TUO4742/SeedlingRobot/mechanical/四自由度/四自由度平行爪子.STEP

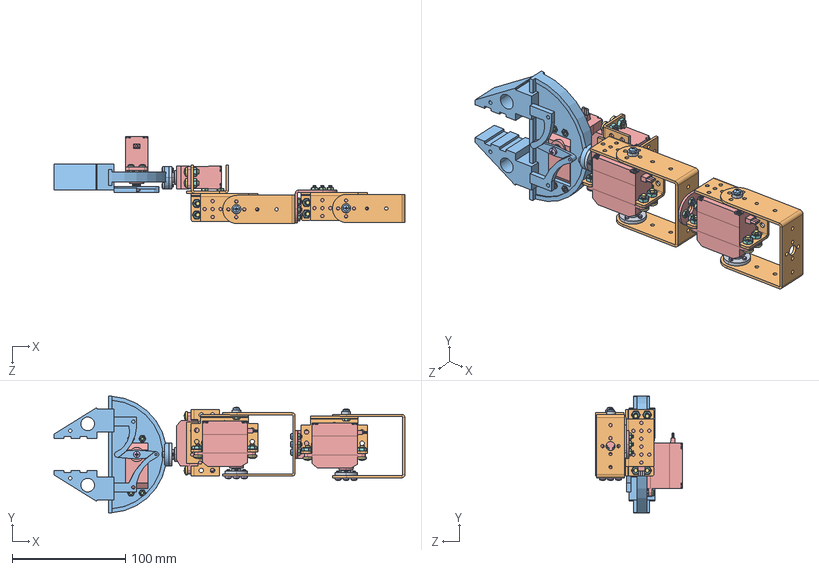
[picture p2: CAD file, 2026-10-20]
mechanical/四自由度/四自由度平行爪子.STEP
309.8 x 103.0 x 76.9 mm
ｱｭﾊｽﾖ盖ﾐ x 2
舵机支架 x 3
cross recessed pan head screws gb_GB_CROSS_SCREWS_TYPE1 M3X8-8 H type-S x 12
hex nuts, style 1-grades ab gb_GB_FASTENER_NUT_SNAB1 M3-S x 20
单轴舵机 x 4
cross recessed pan head screws gb_GB_CROSS_SCREWS_TYPE1 M3X6-6 H type-S x 14
cross recessed pan head screws gb_GB_CROSS_SCREWS_TYPE1 M4X10-10 H type-S x 12
hex nuts, style 1-grades ab gb_GB_FASTENER_NUT_SNAB1 M4-S x 12
金属主舵盘 x 3
酗U盓殤 x 2
す俴盓殤
cross recessed pan head screws gb_GB_CROSS_SCREWS_TYPE1 M3X10-10 H type-S x 4
L倰盓殤
