TUO4742/SeedlingRobot/mechanical/横梁/prt0004.stp

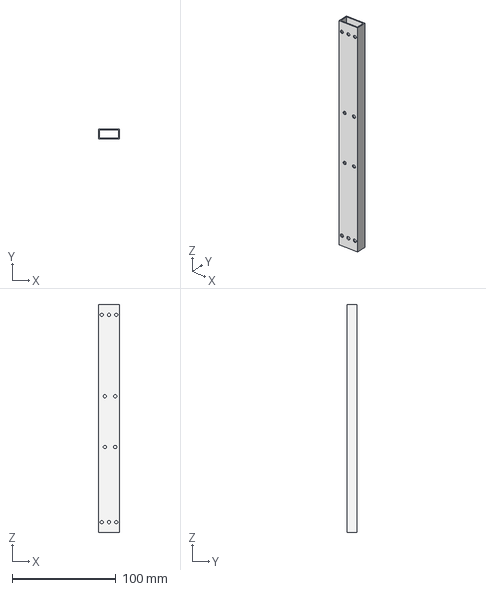
[picture p3: CAD file, 2026-10-20]
mechanical/横梁/prt0004.stp
20.0 x 10.0 x 220.0 mm
