TUO4742/SeedlingRobot/mechanical/完整小车.SLDASM

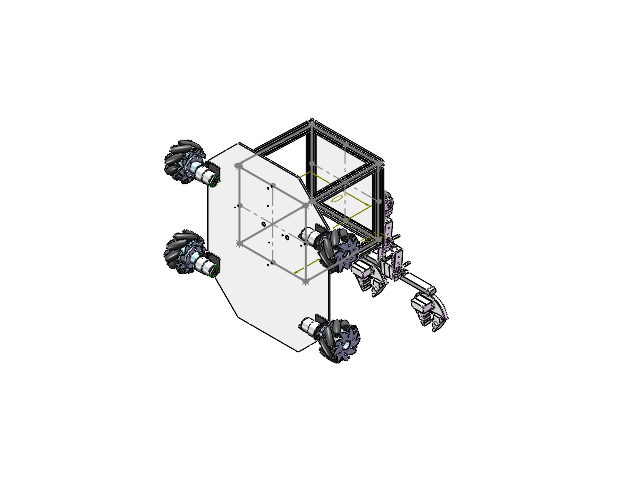
[picture p4: CAD file, 2026-10-20]
mechanical/完整小车.SLDASM
底盘
电机支架_MG513电机支架(37支架） x 4
直流电机_MG513P30（P20）-12V（霍尔） x 4
100mm麦轮_左 x 2
100mm麦轮_右 x 2
轴直径8mm_外径56.8mm_抱紧式联轴器_带法兰 x 4
铝型材支架
云台 x 2
零件18^小车底盘
u型支架 x 3
多功能支架 x 5
舵机 x 4
圆盘 x 2
90度支架
prt0004
夹爪 x 2
