TUO4742/SeedlingRobot/(list of files, cad)

Other CAD files:
mechanical/四自由度/四自由度平行爪子.DXF
mechanical/横梁/prt0004.STL
