TUO4742/SeedlingRobot/hardware/睿抗-摘苗机器人pcb/WLKJ2025011CAR-MOTOR-V1.2.kicad_pcb

## KiCad design hardware/睿抗-摘苗机器人pcb/WLKJ2025011CAR-MOTOR-V1.2.kicad_pcb (2026-10-20)

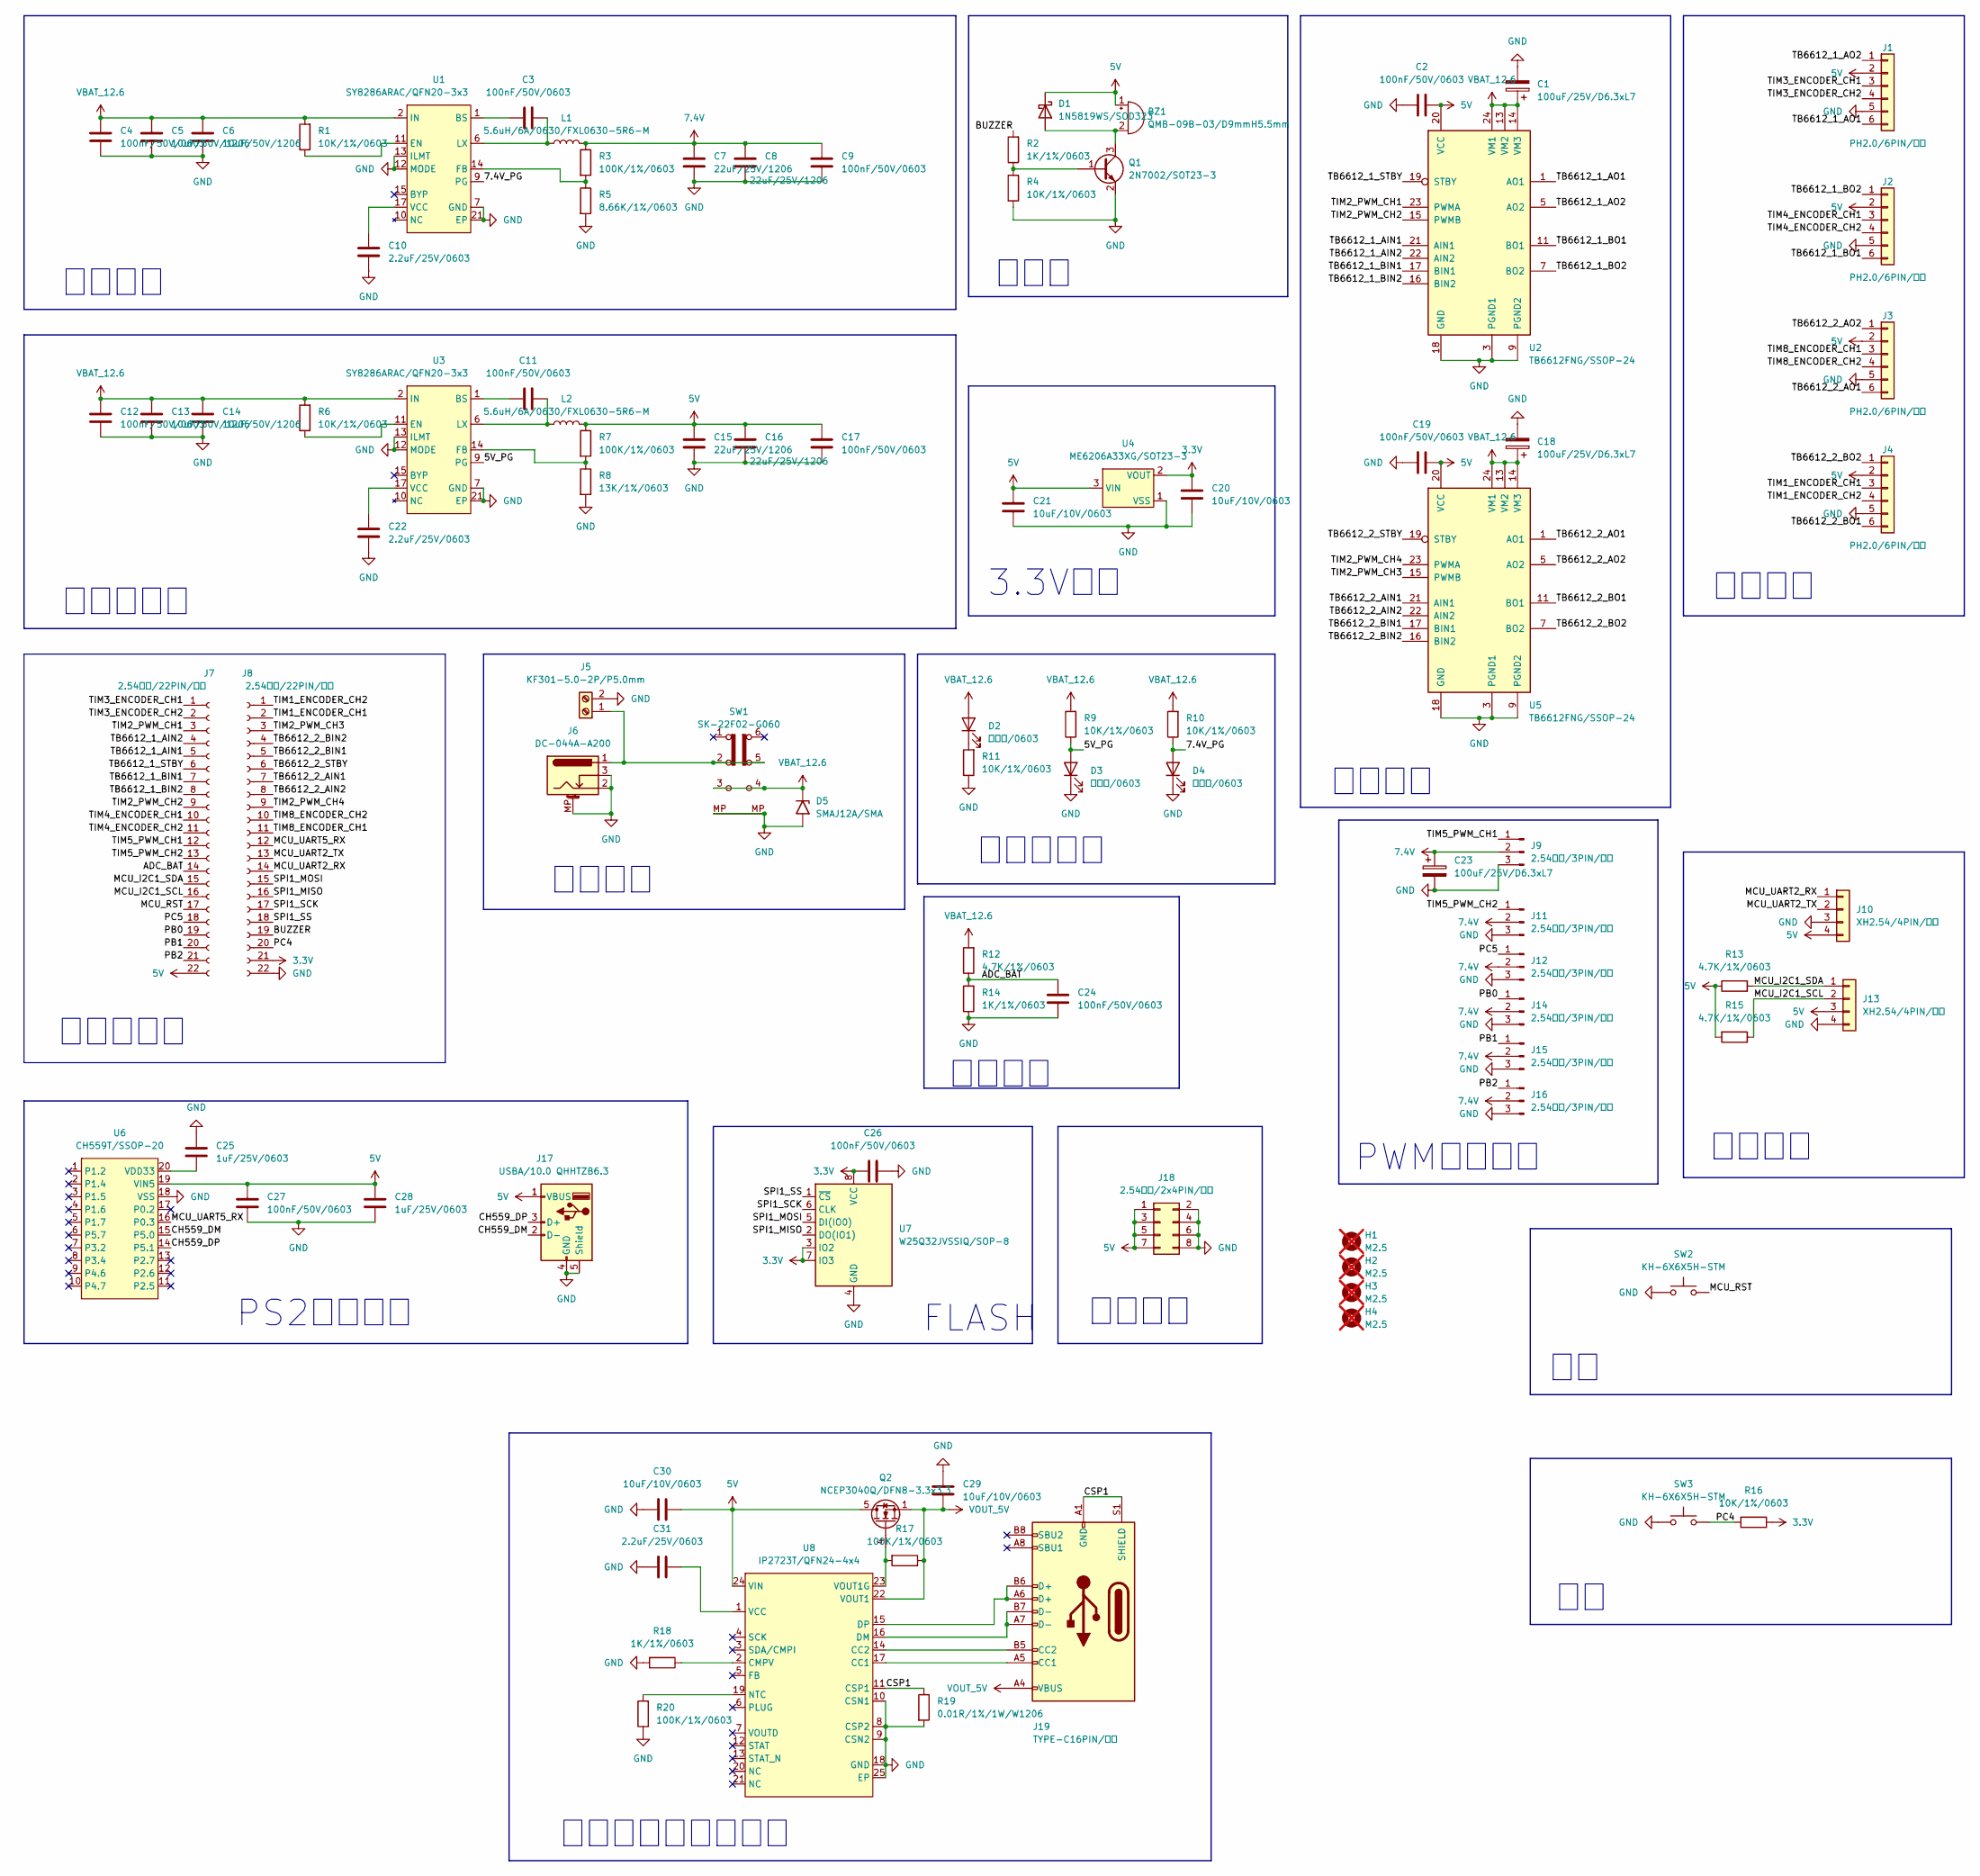
[picture p5: schematic WLKJ2025011CAR-MOTOR-V1.2.kicad_sch, 智能小车控制板]

Parts:
BZ1: QMB-09B-03/D9mmH5.5mm; Buzzer_D9_H5.5_P5
C1, C18, C23: 100uF/25V/D6.3xL7; CP_Radial_D6.3mm_P2.50mm
C2, C3, C4, C9, C11, C12, C17, C19, C24, C26, C27: 100nF/50V/0603; C_0603_1608Metric
C5, C6, C13, C14: 10uF/50V/1206; C_1206_3216Metric
C7, C8, C15, C16: 22uF/25V/1206; C_1206_3216Metric
C10, C22, C31: 2.2uF/25V/0603; C_0603_1608Metric
C20, C21, C29, C30: 10uF/10V/0603; C_0603_1608Metric
C25, C28: 1uF/25V/0603; C_0603_1608Metric
D1: 1N5819WS/SOD323; D_SOD-323_HandSoldering
D2, D3, D4: 翠绿色/0603; LED_0603_1608Metric
D5: SMAJ12A/SMA; D_SMA
H1, H2, H3, H4: M2.5; MountingHole_2.7mm_M2.5; not fitted
J1, J2, J3, J4: PH2.0/6PIN/直插; JST_PH_B6B-PH-K_1x06_P2.00mm_Vertical
J5: KF301-5.0-2P/P5.0mm; TerminalBlock_Phoenix_MKDS-1,5-2_1x02_P5.00mm_Horizontal
J6: DC-044A-A200; BarrelJack_CUI_PJ-079BH_Horizontal
J7, J8: 2.54排母/22PIN/直插; PinSocket_1x22_P2.54mm_Vertical
J9, J11, J12, J14, J15, J16: 2.54排针/3PIN/直插; PinHeader_1x03_P2.54mm_Vertical
J10, J13: XH2.54/4PIN/直插; JST_XH_B4B-XH-A_1x04_P2.50mm_Vertical
J17: USBA/10.0 QHHTZB6.3; USB_A_TH_10x6.8mm_Horizontal
J18: 2.54排针/2x4PIN/直插; PinHeader_2x04_P2.54mm_Vertical
J19: TYPE-C16PIN/卧插; USB_C_Receptacle_GCT_USB4105-xx-A_16P_TopMnt_Horizontal
L1, L2: 5.6uH/6A/0630/FXL0630-5R6-M; L_Changjiang_FXL0630
Q1: 2N7002/SOT23-3; SOT-23
Q2: NCEP3040Q/DFN8-3.3x3.3; VSON-8_3.3x3.3mm_P0.65mm_NexFET
R1, R4, R6, R9, R10, R11, R16: 10K/1%/0603; R_0603_1608Metric
R2, R14, R18: 1K/1%/0603; R_0603_1608Metric
R3, R7, R17, R20: 100K/1%/0603; R_0603_1608Metric
R5: 8.66K/1%/0603; R_0603_1608Metric
R8: 13K/1%/0603; R_0603_1608Metric
R12, R13, R15: 4.7K/1%/0603; R_0603_1608Metric
R19: 0.01R/1%/1W/W1206; R_1206_3216Metric
SW1: SK-22F02-G060; SK-22F02
SW2, SW3: KH-6X6X5H-STM; SW_PUSH_6x6
U1, U3: SY8286ARAC/QFN20-3x3; QFN-20-1EP_3x3mm_P0.45mm_EP1.6x1.6mm
U2, U5: TB6612FNG/SSOP-24; SSOP-24_5.3x8.2mm_P0.65mm
U4: ME6206A33XG/SOT23-3; TSOT-23
U6: CH559T/SSOP-20; SSOP-20_5.3x7.2mm_P0.65mm
U7: W25Q32JVSSIQ/SOP-8; SOIC-8_5.23x5.23mm_P1.27mm
U8: IP2723T/QFN24-4x4; QFN-24-1EP_4x4mm_P0.5mm_EP2.5x2.5mm

Connections:
3.3V: C20.2, C26.1, J8.21, R16.1, U4.2 (VOUT), U7.3 (IO2), U7.7 (IO3), U7.8 (VCC)
5V: BZ1.1 (+), C2.2, C15.2, C16.2, C17.2, C19.2, C21.2, C27.2, C28.2, C30.1, D1.1 (K), J1.2, J2.2, J3.2, J4.2, J7.22, J10.4, J13.3, J17.1 (VBUS), J18.1, J18.3, J18.5, J18.7, L2.2, Q2.5 (D), R7.1, R13.1, R15.2, U2.20 (VCC), U4.3 (VIN), U5.20 (VCC), U6.19 (VIN5), U8.24 (VIN)
7.4V: C7.2, C8.2, C9.2, C23.1, J9.2, J11.2, J12.2, J14.2, J15.2, J16.2, L1.2, R3.1
/5V_PG: D3.2 (A), R9.1, U3.9 (PG)
/7.4V_PG: D4.2 (A), R10.1, U1.9 (PG)
/ADC_BAT: C24.2, J7.14, R12.1, R14.2
/BUZZER: J8.19, R2.2
/CH559_DM: J17.2 (D-), U6.15 (P5.0)
/CH559_DP: J17.3 (D+), U6.14 (P5.1)
/CSP1: J19.A1 (GND), J19.A12 (GND), J19.B1 (GND), J19.B12 (GND), J19.S1 (SHIELD), R19.1, U8.11 (CSP1)
/MCU_I2C1_SCL: J7.16, J13.2, R15.1
/MCU_I2C1_SDA: J7.15, J13.1, R13.2
/MCU_RST: J7.17, SW2.2
/MCU_UART2_RX: J8.14, J10.1
/MCU_UART2_TX: J8.13, J10.2
/MCU_UART5_RX: J8.12, U6.16 (P0.3)
/PB0: J7.19, J14.1
/PB1: J7.20, J15.1
/PB2: J7.21, J16.1
/PC4: J8.20, R16.2, SW3.2
/PC5: J7.18, J12.1
/SPI1_MISO: J8.16, U7.2 (DO(IO1))
/SPI1_MOSI: J8.15, U7.5 (DI(IO0))
/SPI1_SCK: J8.17, U7.6 (CLK)
/SPI1_SS: J8.18, U7.1 (~CS)
/TB6612_1_AIN1: J7.5, U2.21 (AIN1)
/TB6612_1_AIN2: J7.4, U2.22 (AIN2)
/TB6612_1_AO1: J1.6, U2.1 (AO1), U2.2 (AO1)
/TB6612_1_AO2: J1.1, U2.5 (AO2), U2.6 (AO2)
/TB6612_1_BIN1: J7.7, U2.17 (BIN1)
/TB6612_1_BIN2: J7.8, U2.16 (BIN2)
/TB6612_1_BO1: J2.6, U2.11 (BO1), U2.12 (BO1)
/TB6612_1_BO2: J2.1, U2.7 (BO2), U2.8 (BO2)
/TB6612_1_STBY: J7.6, U2.19 (STBY)
/TB6612_2_AIN1: J8.7, U5.21 (AIN1)
/TB6612_2_AIN2: J8.8, U5.22 (AIN2)
/TB6612_2_AO1: J3.6, U5.1 (AO1), U5.2 (AO1)
/TB6612_2_AO2: J3.1, U5.5 (AO2), U5.6 (AO2)
/TB6612_2_BIN1: J8.5, U5.17 (BIN1)
/TB6612_2_BIN2: J8.4, U5.16 (BIN2)
/TB6612_2_BO1: J4.6, U5.11 (BO1), U5.12 (BO1)
/TB6612_2_BO2: J4.1, U5.7 (BO2), U5.8 (BO2)
/TB6612_2_STBY: J8.6, U5.19 (STBY)
/TIM1_ENCODER_CH1: J4.3, J8.2
/TIM1_ENCODER_CH2: J4.4, J8.1
/TIM2_PWM_CH1: J7.3, U2.23 (PWMA)
/TIM2_PWM_CH2: J7.9, U2.15 (PWMB)
/TIM2_PWM_CH3: J8.3, U5.15 (PWMB)
/TIM2_PWM_CH4: J8.9, U5.23 (PWMA)
/TIM3_ENCODER_CH1: J1.3, J7.1
/TIM3_ENCODER_CH2: J1.4, J7.2
/TIM4_ENCODER_CH1: J2.3, J7.10
/TIM4_ENCODER_CH2: J2.4, J7.11
/TIM5_PWM_CH1: J7.12, J9.1
/TIM5_PWM_CH2: J7.13, J11.1
/TIM8_ENCODER_CH1: J3.3, J8.11
/TIM8_ENCODER_CH2: J3.4, J8.10
GND: C1.2, C2.1, C4.1, C5.1, C6.1, C7.1, C8.1, C9.1, C10.1, C12.1, C13.1, C14.1, C15.1, C16.1, C17.1, C18.2, C19.1, C20.1, C21.1, C22.1, C23.2, C24.1, C25.2, C26.2, C27.1, C28.1, C29.1, C30.2, C31.2, D3.1 (K), D4.1 (K), D5.2 (A2), J1.5, J2.5, J3.5, J4.5, J5.2, J6.2, J6.3, J6.MP (MountPin), J8.22, J9.3, J10.3, J11.3, J12.3, J13.4, J14.3, J15.3, J16.3, J17.4 (GND), J17.5 (Shield), J18.2, J18.4, J18.6, J18.8, Q1.2 (E), R4.1, R5.2, R8.2, R11.1, R14.1, R18.2, R19.2, R20.1, SW1.MP, SW2.1, SW3.1, U1.7 (GND), U1.8 (GND), U1.12 (MODE), U1.13 (ILMT), U1.18 (GND), U1.21 (EP), U2.3 (PGND1), U2.4 (PGND1), U2.9 (PGND2), U2.10 (PGND2), U2.18 (GND), U3.7 (GND), U3.8 (GND), U3.12 (MODE), U3.13 (ILMT), U3.18 (GND), U3.21 (EP), U4.1 (VSS), U5.3 (PGND1), U5.4 (PGND1), U5.9 (PGND2), U5.10 (PGND2), U5.18 (GND), U6.18 (VSS), U7.4 (GND), U8.8 (CSP2), U8.9 (CSN2), U8.10 (CSN1), U8.18 (GND), U8.25 (EP)
unnamed: BZ1.2 (-), D1.2 (A), Q1.3 (C)
unnamed: C3.2, L1.1, U1.6 (LX), U1.19 (LX), U1.20 (LX)
unnamed: C11.2, L2.1, U3.6 (LX), U3.19 (LX), U3.20 (LX)
unnamed: D2.1 (K), R11.2
unnamed: J5.1, J6.1, SW1.2 (B), SW1.5 (B)
unnamed: J19.A5 (CC1), U8.17 (CC1)
unnamed: J19.B5 (CC2), U8.14 (CC2)
unnamed: Q1.1 (B), R2.1, R4.2
unnamed: Q2.4 (G), R17.2, U8.23 (VOUT1G)
unnamed: C3.1, U1.1 (BS)
unnamed: R1.1, U1.11 (EN)
unnamed: R3.2, R5.1, U1.14 (FB)
unnamed: C10.2, U1.17 (VCC)
unnamed: C11.1, U3.1 (BS)
unnamed: R6.1, U3.11 (EN)
unnamed: R7.2, R8.1, U3.14 (FB)
unnamed: C22.2, U3.17 (VCC)
unnamed: C25.1, U6.20 (VDD33)
unnamed: R18.1, U8.2 (CMPV)
unnamed: J19.A7 (D-), J19.B7 (D-), U8.16 (DM)
unnamed: J19.A6 (D+), J19.B6 (D+), U8.15 (DP)
unnamed: R20.2, U8.19 (NTC)
unnamed: C31.1, U8.1 (VCC)
VBAT_12.6: C1.1, C4.2, C5.2, C6.2, C12.2, C13.2, C14.2, C18.1, D2.2 (A), D5.1 (A1), R1.2, R6.2, R9.2, R10.2, R12.2, SW1.3 (C), SW1.4 (A), U1.2 (IN), U1.3 (IN), U1.4 (IN), U1.5 (IN), U2.13 (VM2), U2.14 (VM3), U2.24 (VM1), U3.2 (IN), U3.3 (IN), U3.4 (IN), U3.5 (IN), U5.13 (VM2), U5.14 (VM3), U5.24 (VM1)
VOUT_5V: C29.2, J19.A4 (VBUS), J19.A9 (VBUS), J19.B4 (VBUS), J19.B9 (VBUS), Q2.1 (S), Q2.2 (S), Q2.3 (S), R17.1, U8.22 (VOUT1)

Notes on the sheet:
FLASH
蜂鸣器
电机接口
PWM舵机接口
3.3V电源
拓展接口
PS2手柄接口
电压检测
核心板接口
树莓派供电协议芯片
电源接口
舵机供电
电机驱动
树莓派供电
电源指示灯

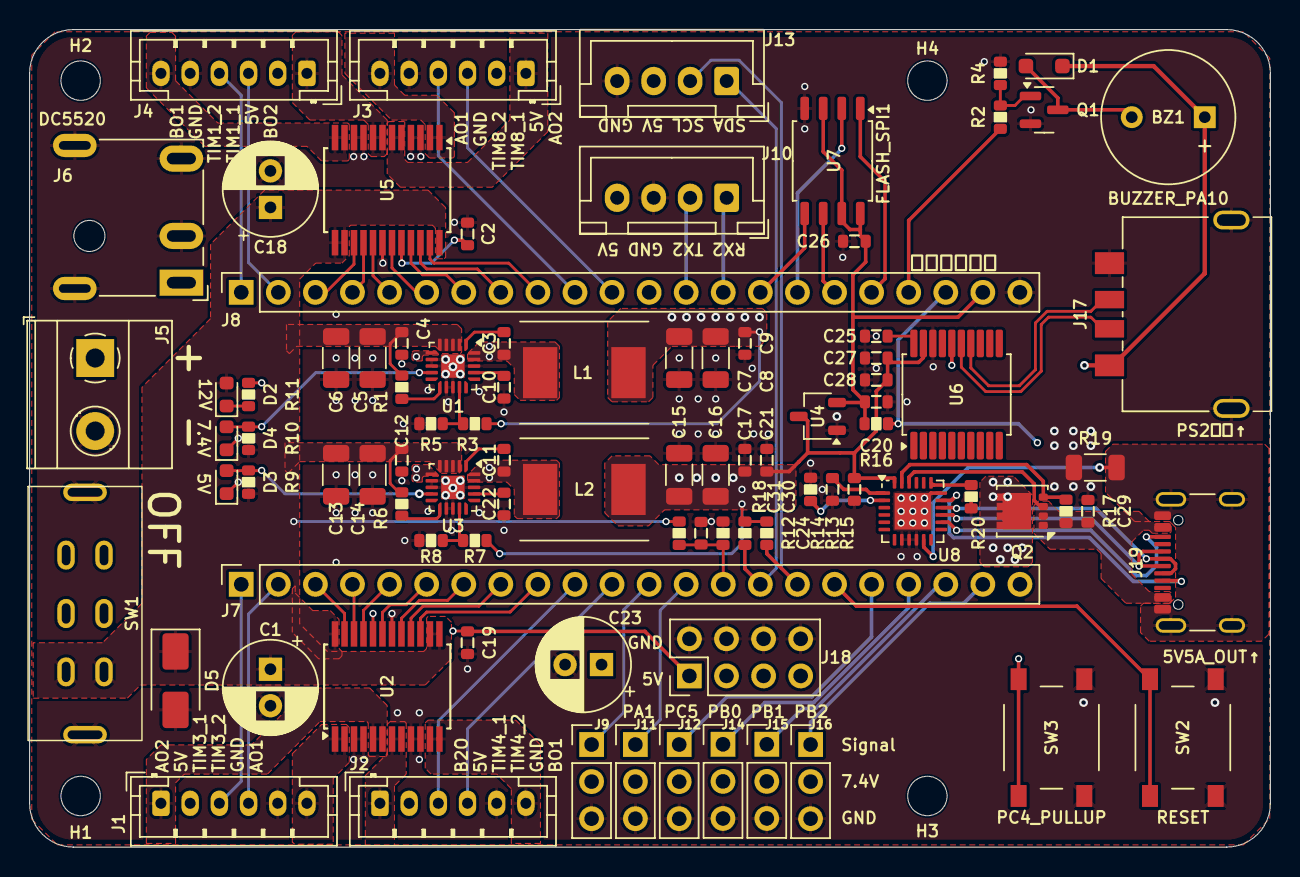
[picture p6: board WLKJ2025011CAR-MOTOR-V1.2.kicad_pcb from above]

Board: 4 copper layers, 85.0 x 56.0 mm, 95 parts (0 on the bottom side), 83 nets.
