TUO4742/SeedlingRobot/(commit log)

2026-10-20 feat: publish initial project archive
    [WLKJ2025011CAR-MOTOR-V1.2.kicad_pcb, WLKJ2025011CAR-MOTOR-V1.2.kicad_sch, prt0004.STL, prt0004.stp, 四自由度平行爪子.DXF, 四自由度平行爪子.STEP, 完整小车.SLDASM]
2026-10-20 feat: add ROS2 navigation stack for mecanum chassis
    [seedling_robot.urdf]
