TUO4742/SeedlingRobot/(notices)

Notices in the files:
firmware/stm32/Src/tim.c:
Copyright (c) 2026 STMicroelectronics.
All rights reserved.
This software is licensed under terms that can be found in the LICENSE file
